FedePiero/Progetto-IoT/README.txt

In questa repository si trovano: 
	-Relazione progetto.
	-CodiceArduino: cartella con i 4 script di Arduino.
	-CodicePython: cartella con lo script utilizzato per prelevare i dati dalla porta seriale e inviarli al 	DBMS.
	-presentazione.
	-progettoIoT.mp4: video illustrativo sul progetto. 
	NB: nel video per simulare l'allontanamento del modulo bluetooth Slave, si sono staccati i fili della 		corrente.
